fsegurac/Out2/README.md

<<<<<<< HEAD
# Out2
Simulaciones y demás archivos usados para el proyecto de la materia electrónica análoga II de la Universidad Nacional de Colombia
