fsegurac/Out2/Latex/photos/diferencial.png

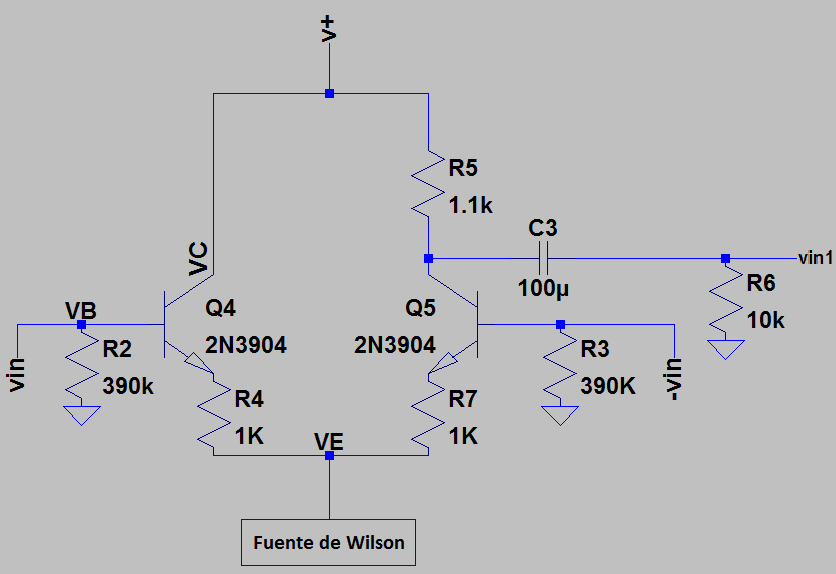
Latex/photos/diferencial.png
