fsegurac/Out2/Latex/photos/diferencial_sim.png

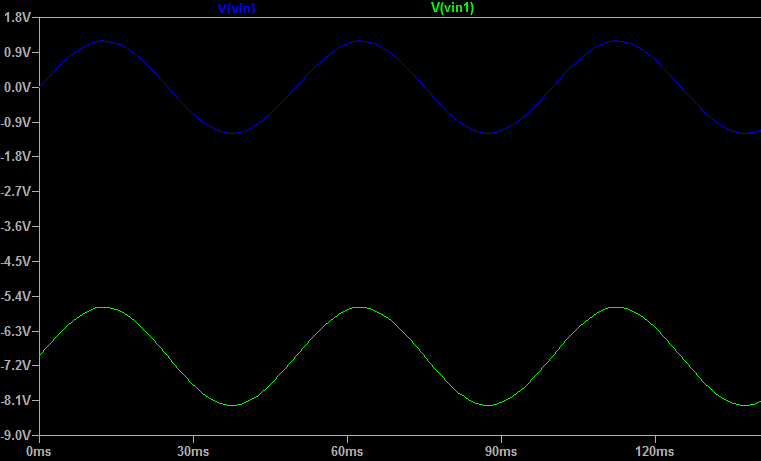
Latex/photos/diferencial_sim.png
