fsegurac/Out2/Latex/photos/diferencial_sim_db.png

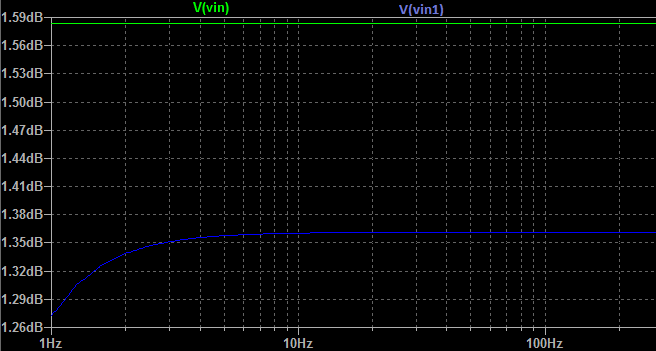
Latex/photos/diferencial_sim_db.png
