fsegurac/Out2/Latex/photos/inout_dif.png

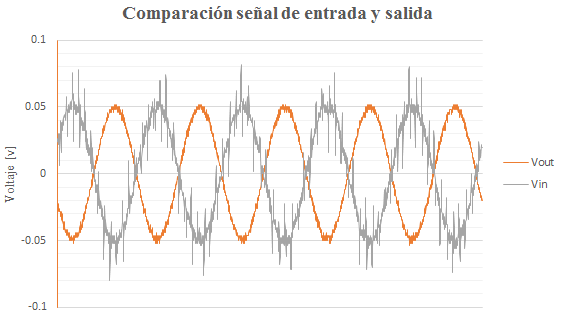
Latex/photos/inout_dif.png
