fsegurac/Out2/Latex/photos/no_pasa_baja.png

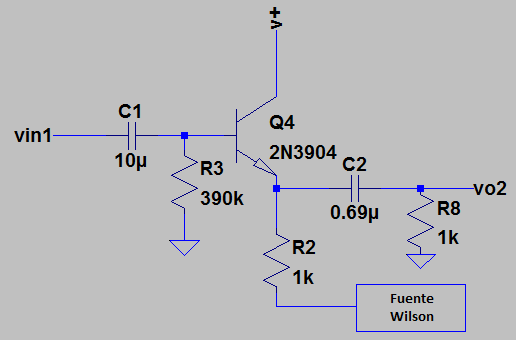
Latex/photos/no_pasa_baja.png
