fsegurac/Out2/Latex/photos/pasa_baja.png

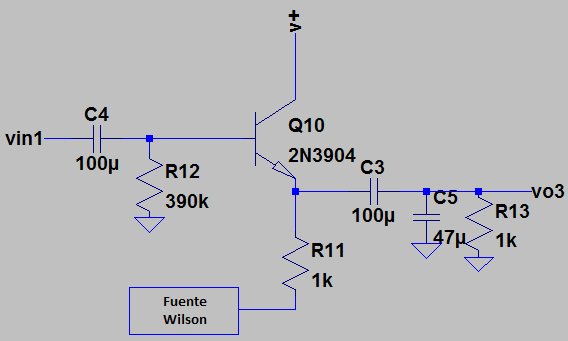
Latex/photos/pasa_baja.png
