fsegurac/Out2/Latex/photos/re_fre_dif.png

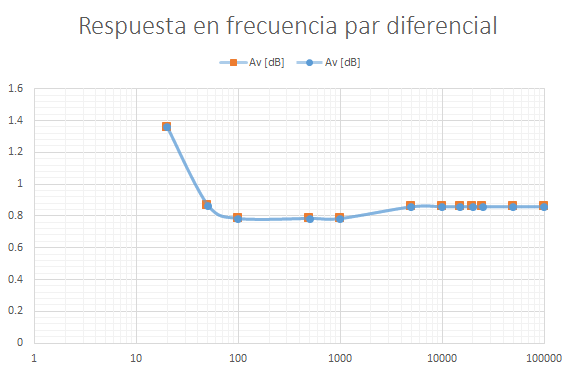
Latex/photos/re_fre_dif.png
