fsegurac/Out2/Latex/photos/res_fr_filtros.png

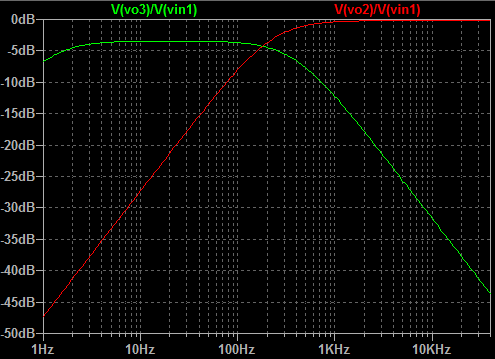
Latex/photos/res_fr_filtros.png
