fsegurac/Out2/Latex/photos/wilson.png

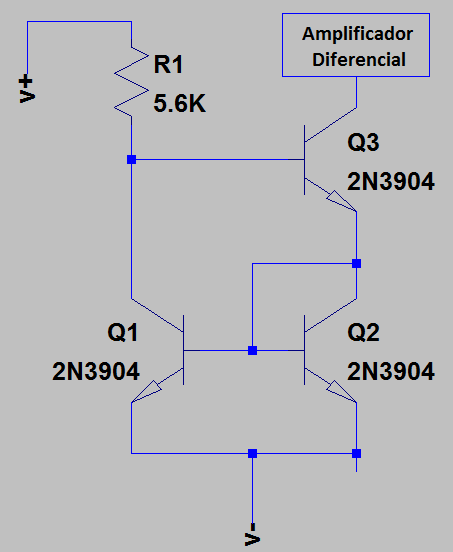
Latex/photos/wilson.png
