fsegurac/Out2/respuesta en frecuencia filtros.png

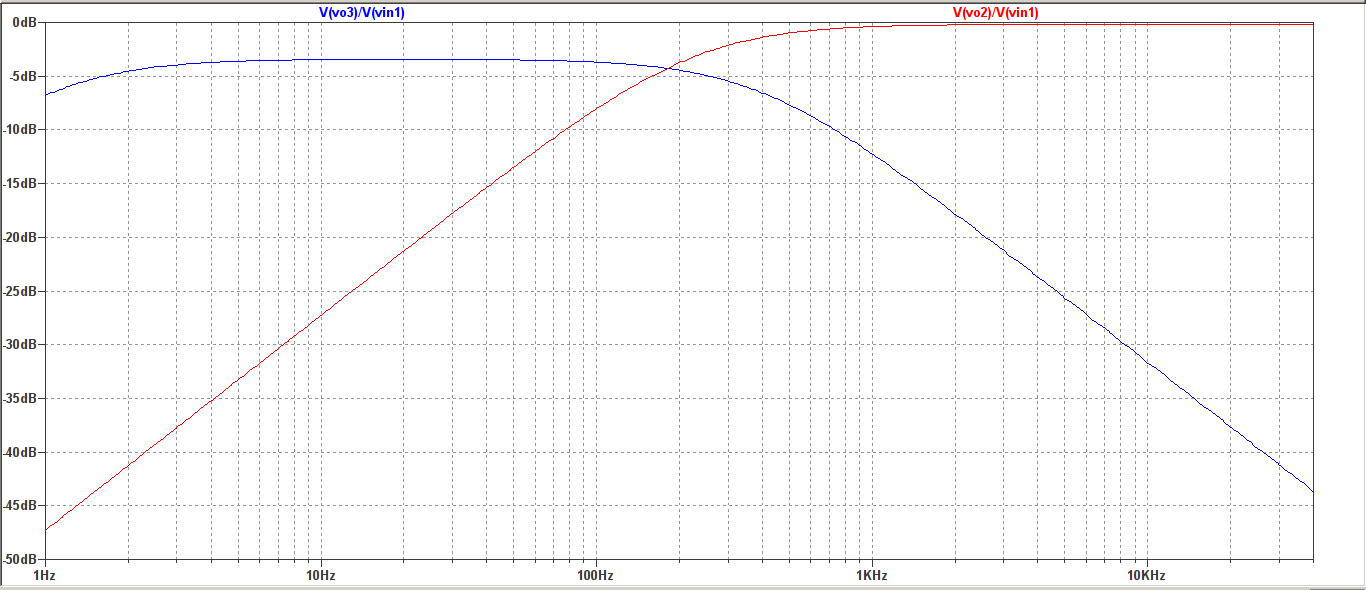
respuesta en frecuencia filtros.png
