fsegurac/Out2/respuestaFrec_dif.png

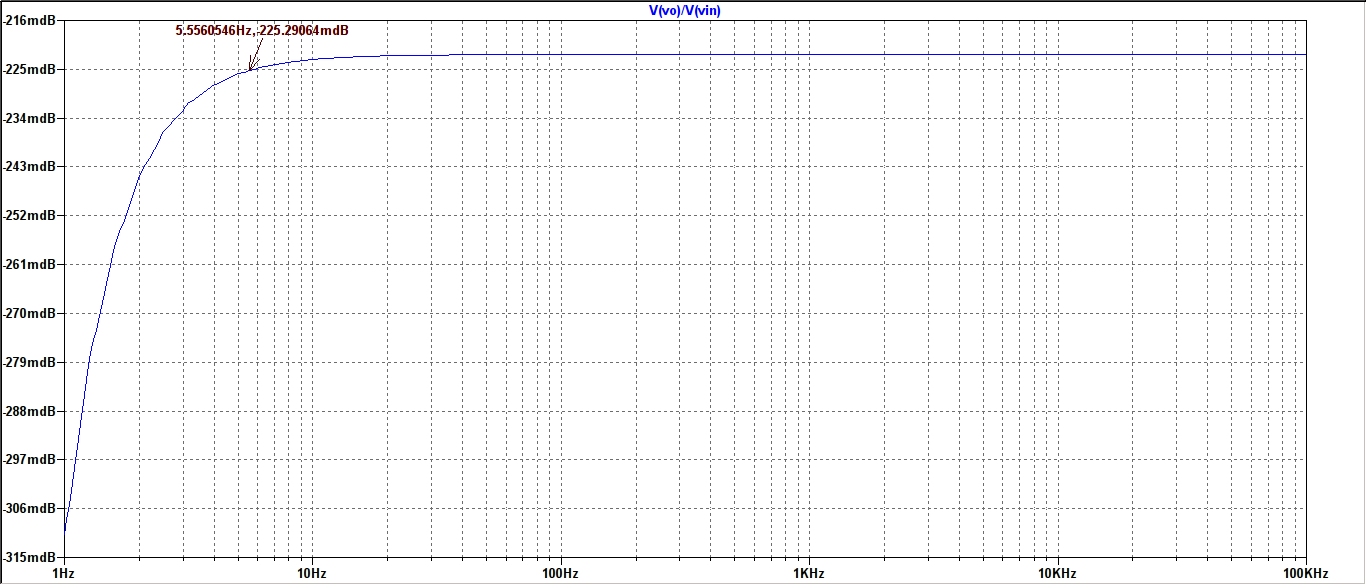
respuestaFrec_dif.png
