fsegurac/Out2/amp_filtrado_potencia.asc

C1: cap; 100µ
C2: cap; .69µ
C3: cap; 100µ
C4: cap; 100µ
C5: cap; 22µ
C6: cap; 100µ
C7: cap; 100µ
C8: cap; 220µ
C9: cap; 220µ
C10: cap; 100µ
C11: cap; 100µ
C12: cap; 100µ
C13: cap; 100µ
C14: cap; 100µ
C15: cap; 100µ
D1: diode; 1N4148
D2: diode; 1N4148
D3: diode; 1N4148
D4: diode; 1N4148
D5: diode; 1N4148
D6: diode; 1N4148
Q1: npn; 2N3904
Q2: npn; 2N3904
Q3: npn; 2N3904
Q4: npn; 2N3904
Q5: npn; 2N3904
Q6: npn; 2N3904
Q7: npn; 2N3904
Q8: npn; 2N3904
Q9: npn; 2N3904
Q10: npn; 2N3904
Q11: npn; 2N3904
Q12: npn; 2N3904
Q13: npn; 2N3904
Q14: npn; 2N3904
Q15: npn; 2N3904
Q16: npn; 2N3904
Q17: npn; 2N3904
Q18: npn; 2N3904
Q19: npn; 2N3904
Q20: npn; 2N3904
Q21: npn; 2N3904
Q22: npn; 2N3904
Q23: npn; 2N3904
Q24: npn; 2N3904
R1: res; 3.3k
R2: res; 1k
R3: res; 390k
R4: res; 5.6K
R5: res; 390k
R6: res; 390K
R7: res; 1.1k
R8: res; 11.3k
R9: res; 1K
R10: res; 1K
R11: res; 1k
R12: res; 390k
R14: res; 5.6k
R15: res; 390k
R16: res; 5k
R17: res; 5k
R18: res; 11.3k
R19: res; 3.3k
R20: res; 240
R21: res; 1k
R22: res; 1
R23: res; 8
R24: res; 1
R25: res; 390k
R26: res; 5k
R27: res; 5k
R28: res; 27k
R29: res; 4.7k
R30: res; 390k
R31: res; 1.2k
R32: res; 240
R33: res; 1k
R34: res; 1
R35: res; 8
R36: res; 1
R37: res; 27k
R38: res; 4.7k
R39: res; 11.3k
R41: res; 1k
R42: res; 1k
R43: res; 1.1k
R44: res; 3k
R45: res; 4.1k
Rvar1: res; 1
Rvar2: res; 1
U1: tip122
U2: tip122
U3: tip127
U4: tip127
V4: voltage; 12
V5: voltage; 12
V6: voltage; SINE(0 1 1k); AC 1.2
V7: voltage; SINE(0 -1 1k); AC -1.2
Named nets: v+, 0, vin1, vo2, VB, VE, v-, vin, -vin, vin2, vo3, vooooo1, vooooo2, -vin1
.tran .1
