fsegurac/Out2/amp_filtrado_audio.asc

C2: cap; 100µ
C3: cap; 100µ
Q1: npn; 2N3904
Q2: npn; 2N3904
Q3: npn; 2N3904
Q4: npn; 2N3904
Q5: npn; 2N3904
Q6: npn; 2N3904
Q7: npn; 2N3904
Q8: npn; 2N3904
Q9: npn; 2N3904
R1: res; 5.6K
R2: res; 1k
R3: res; 200k
R4: res; 5.6K
R5: res; 390k
R6: res; 390K
R7: res; 1.1k
R8: res; 10k
R9: res; 1K
R10: res; 1K
V1: voltage; wavefile=audio.wav
V2: voltage; wavefile=audio.wav
V4: voltage; 12
V5: voltage; 12
V6: voltage; SINE(0 1.2 5k); AC 1.2
V7: voltage; SINE(0 -1.2 5k); AC -1.2
Named nets: v+, v-, 0, vin1, vo2, VB, VE, VC, vin, -vin, vaudio, -vaudio
.tran 0 0.5 0 0.01
