fsegurac/Out2/diferencial_RE1K_valorescomerciales.asc

C3: cap; 100µ
Q1: npn; 2N3904
Q2: npn; 2N3904
Q3: npn; 2N3904
Q4: npn; 2N3904
Q5: npn; 2N3904
R1: res; 5.6K
R2: res; 390k
R3: res; 390K
R4: res; 1K
R5: res; 1.1k
R6: res; 10k
R7: res; 1K
V1: voltage; SINE(0 1.2 20k); AC 1.2
V2: voltage; SINE(0 -1.2 20k); AC -1.2
V6: voltage; 12
V7: voltage; 12
Named nets: vo, 0, VB, VE, VC, v-, v+, vin, -vin
.ac dec 10 1 100K
