fsegurac/Out2/fuenteWilson.asc

Q1: npn; 2N3904
Q2: npn; 2N3904
Q3: npn; 2N3904
R1: res; 5.65k
R2: res; {R}
V1: voltage; 12
V2: voltage; 12
Named nets: 0
.step param R 1 10k 10
.op
