fsegurac/Out2/diferencial_RE1K_valorescomerciales (punto de polarización mas estable).asc

C1: cap; 100µ
C2: cap; 100µ
C3: cap; 100µ
Q1: npn; 2N3904
Q2: npn; 2N3904
Q3: npn; 2N3904
Q4: npn; 2N3904
Q5: npn; 2N3904
R1: res; 5.6K
R2: res; 1500k
R3: res; 1500K
R4: res; 1K
R5: res; 68
R6: res; 10k
R7: res; 1K
V1: voltage; 12
V4: voltage; SINE(0 500m 10k)
V5: voltage; SINE(0 -500m 10k)
V6: voltage; 12
V7: voltage; 12
Named nets: 0, vo, VB, VE, VC, v-, v+
.tran 0 0.0005 0 0.01
