fsegurac/Out2/(list of files, drawings)

Other design files:
pcb/Out2.pdsprj
