fsegurac/Out2/(commit log)

2017-04-03 fuente de corriente
2017-04-10 inicio de etapa de filtrado
2017-04-16 informe avances hasta 16 de abril (70% ?)
2017-04-24 modificación fuente de alimentación
2017-05-22 con otros componentes para el darlington
2017-05-25 +arreglos de la mezcla
2017-05-25 con el inversor y ganancia unitaria
2017-05-25 creo que ya ganancia unitaria para el inversor, y arreglando lo de potencia, ya esta centrado en 0v
2017-05-25 archivos pcb
    [Out2.pdsprj]
